grupodecontrole/Suspended-Pendulum-Plant/(list of files, cad)

Other CAD files:
GUI/Based Works/Initial Work at PIC - RealTimeMeasure/invertedPendulum.X/dist/default/production/invertedPendulum.X.production.obj
GUI/invertedPendulum.X/dist/default/production/invertedPendulum.X.production.obj
