grupodecontrole/Suspended-Pendulum-Plant/Draw.io/Modelagem - Pendulo Invertido.pdf

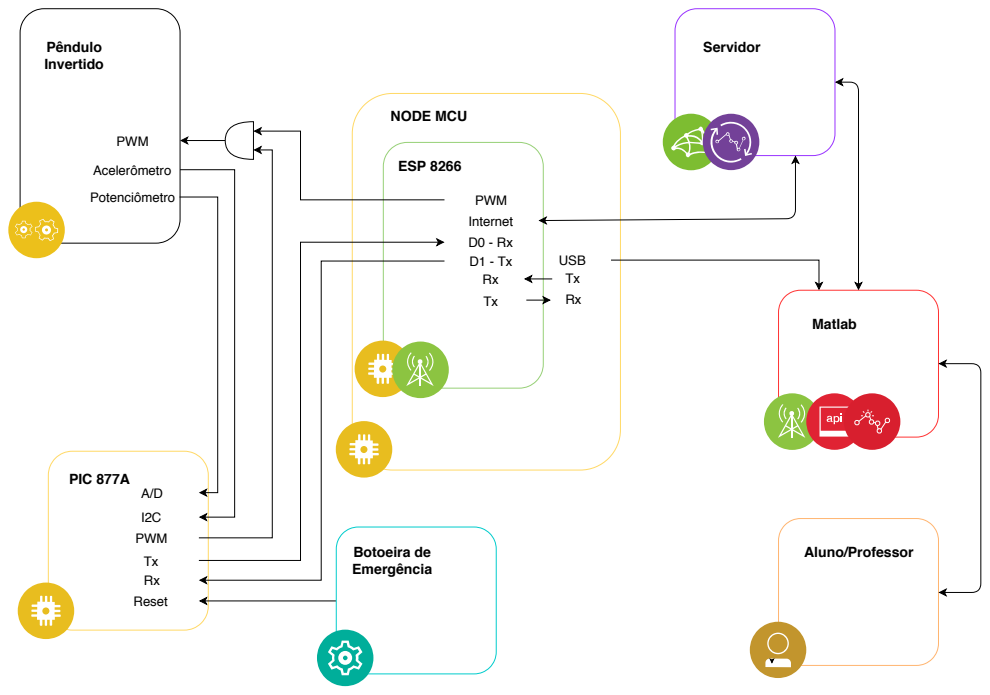
[picture p19: page 1]
PIC 877A; ESP 8266; Matlab; Botoeira de Emergência; PWM; Reset; Pêndulo; Servidor; Invertido; Acelerômetro; Potenciômetro; Internet; Aluno/Professor; NODE MCU; USB Tx
