grupodecontrole/Suspended-Pendulum-Plant/Kicad/board.pdf

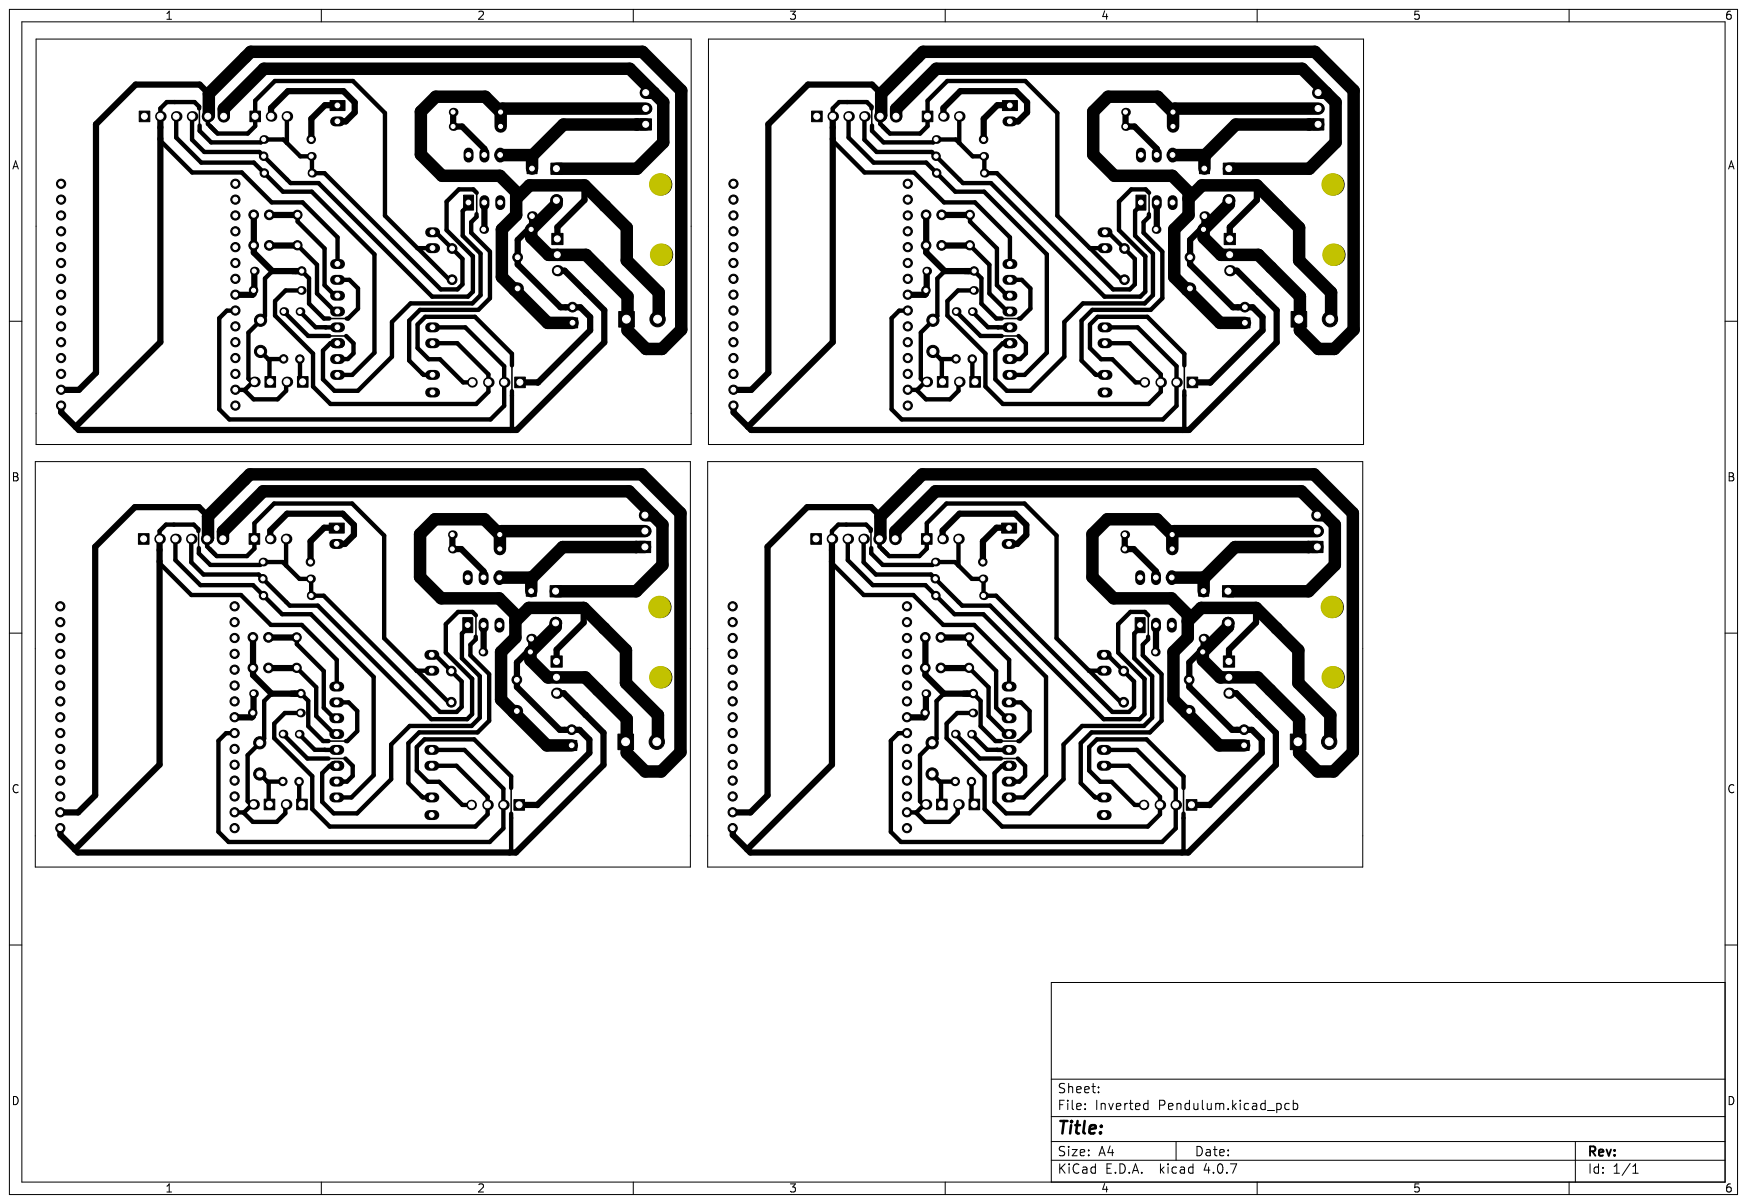
[picture p20: page 1]
