grupodecontrole/Suspended-Pendulum-Plant/(list of files, drawings)

Other design files:
Proteus/Simulation.pdsprj
