grupodecontrole/Suspended-Pendulum-Plant/Kicad/Inverted Pendulum.sch

## KiCad design Kicad/Inverted Pendulum.sch (2018-11-11)

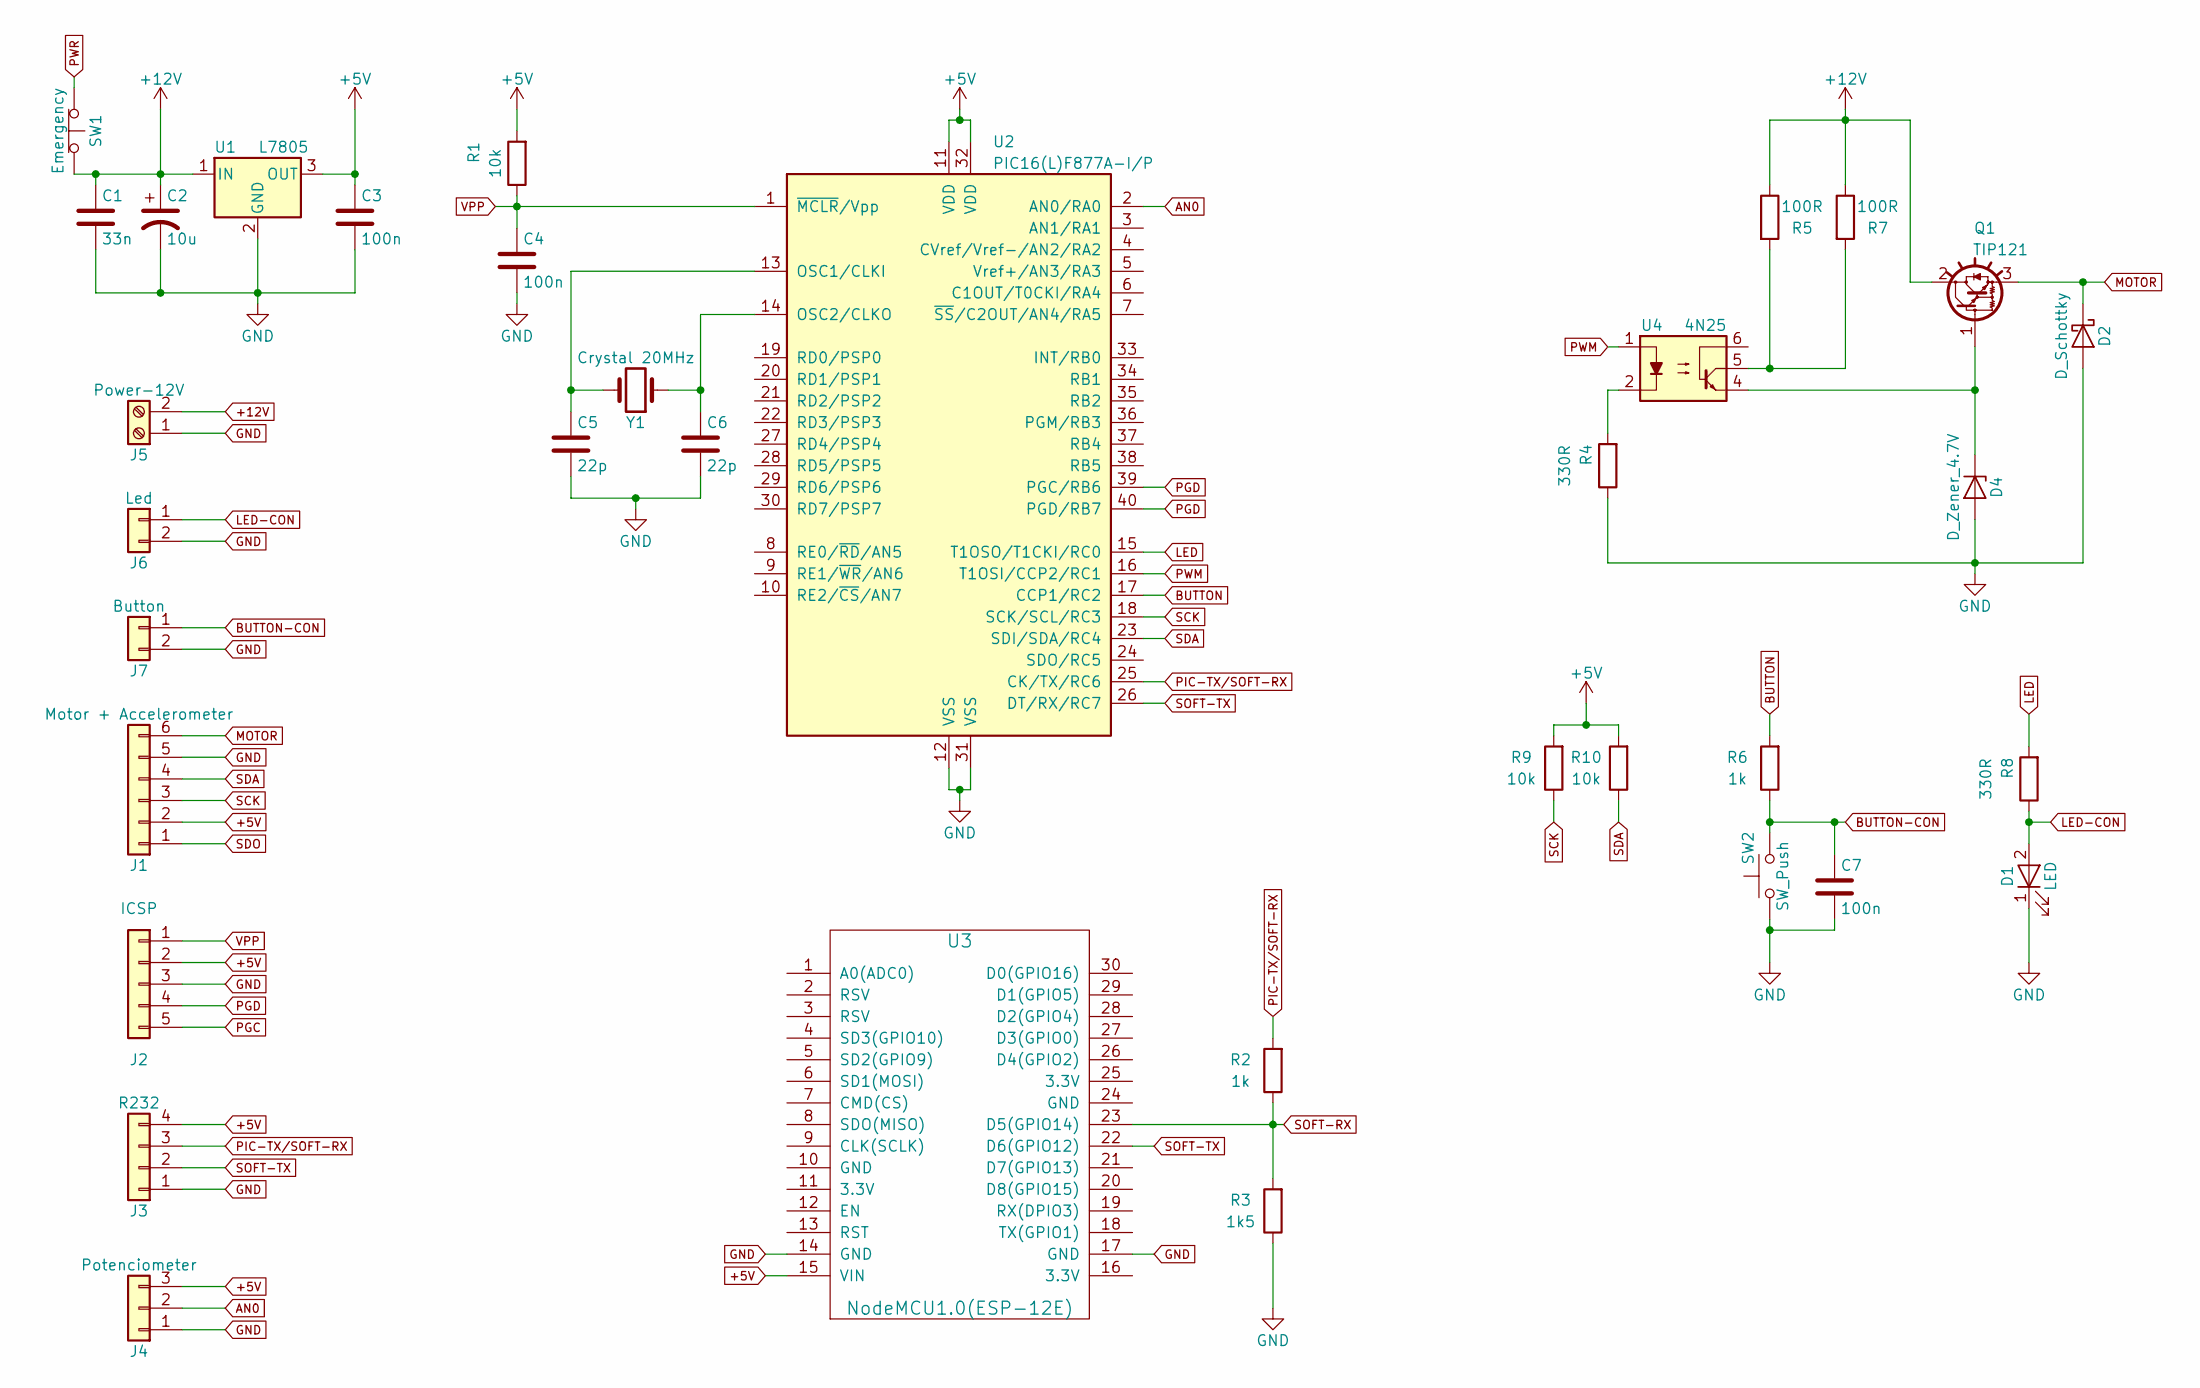
[picture p21: schematic Inverted Pendulum.sch]

Parts:
C1: 33n; C_Disc_D7.5mm_W4.4mm_P5.00mm
C2: 10u; CP_Radial_D7.5mm_P2.50mm
C3, C4, C7: 100n; C_Disc_D7.5mm_W5.0mm_P5.00mm
C5, C6: 22p; C_Disc_D3.8mm_W2.6mm_P2.50mm
D1: LED
D2: D_Schottky; TO-220-2_Horizontal
D4: D_Zener_4.7V; D_DO-35_SOD27_P7.62mm_Horizontal
J1: Motor + Accelerometer; Pin_Header_Angled_1x06_Pitch2.54mm
J2: ICSP
J3: R232; Pin_Header_Angled_1x04_Pitch2.54mm
J4: Potenciometer; Pin_Header_Angled_1x03_Pitch2.54mm
J5: Power-12V; TerminalBlock_Phoenix_MKDS1.5-2pol
J6: Led; Pin_Header_Angled_1x02_Pitch2.54mm
J7: Button; Pin_Header_Angled_1x02_Pitch2.54mm
Q1: TIP121; TO-220-3_Vertical
R1, R9, R10: 10k; R_Axial_DIN0204_L3.6mm_D1.6mm_P7.62mm_Horizontal
R2, R6: 1k; R_Axial_DIN0204_L3.6mm_D1.6mm_P7.62mm_Horizontal
R3: 1k5; R_Axial_DIN0204_L3.6mm_D1.6mm_P7.62mm_Horizontal
R4, R8: 330R; R_Axial_DIN0204_L3.6mm_D1.6mm_P7.62mm_Horizontal
R5, R7: 100R; R_Axial_DIN0204_L3.6mm_D1.6mm_P7.62mm_Horizontal
SW1: Emergency
SW2: SW_Push
U1: L7805; TO-220-3_Horizontal
U2: PIC16(L)F877A-I/P; DIP-40_W15.24mm_LongPads
U3: NodeMCU1.0(ESP-12E); NodeMCU1.0(12-E)
U4: 4N25; DIP-6_W7.62mm_LongPads
Y1: Crystal 20MHz; Crystal_HC49-4H_Vertical

Connections:
+5V: C3.1, J1.2, J2.2, J3.4, J4.3, R1.2, R9.2, R10.2, U1.3 (OUT), U2.11 (VDD), U2.32 (VDD), U3.15 (VIN)
+12V: C1.1, C2.1, J5.2, Q1.2 (C), R5.1, R7.1, SW1.2 (B), U1.1 (IN)
AN0: J4.2, U2.2 (AN0/RA0)
BUTTON: R6.2, U2.17 (CCP1/RC2)
BUTTON-CON: C7.1, J7.1, R6.1, SW2.2
GND: C1.2, C2.2, C3.2, C4.2, C5.2, C6.2, C7.2, D1.1 (K), D2.2 (A), D4.2 (A), J1.5, J2.3, J3.1, J4.1, J5.1, J6.2, J7.2, R3.1, R4.1, SW2.1, U1.2 (GND), U2.12 (VSS), U2.31 (VSS), U3.14 (GND), U3.17 (GND)
LED: R8.2, U2.15 (T1OSO/T1CKI/RC0)
LED-CON: D1.2 (A), J6.1, R8.1
MOTOR: D2.1 (K), J1.6, Q1.3 (E)
unnamed: C5.1, U2.13 (OSC1/CLKI), Y1.2
unnamed: C6.1, U2.14 (OSC2/CLKO), Y1.1
unnamed: D4.1 (K), Q1.1 (B), U4.4
unnamed: R4.2, U4.2
unnamed: R5.2, R7.2, U4.5
PGC: J2.5
PGD: J2.4, U2.39 (PGC/RB6), U2.40 (PGD/RB7)
PIC-TX/SOFT-RX: J3.3, R2.2, U2.25 (CK/TX/RC6)
PWM: U2.16 (T1OSI/CCP2/RC1), U4.1
PWR: SW1.1 (A)
SCK: J1.3, R9.1, U2.18 (SCK/SCL/RC3)
SDA: J1.4, R10.1, U2.23 (SDI/SDA/RC4)
SDO: J1.1
SOFT-RX: R2.1, R3.2, U3.23 (D5(GPIO14))
SOFT-TX: J3.2, U2.26 (DT/RX/RC7), U3.22 (D6(GPIO12))
VPP: C4.1, J2.1, R1.1, U2.1 (~MCLR~/Vpp)
