grupodecontrole/Suspended-Pendulum-Plant/GUI/Based Works/accelerometer_arduino/accelerometer_arduino.ino

#include <Wire.h>
#define accel_module (0x53) //Ground the SD0
byte values[6] ;
char output[512];

void setup(){
  Wire.begin();
  Serial.begin(9600);
  
  Wire.beginTransmission(accel_module);
  Wire.write(0x2D);
  Wire.write(0);
  Wire.endTransmission();
  Wire.beginTransmission(accel_module);
  Wire.write(0x2D);
  Wire.write(16);
  Wire.endTransmission();
  Wire.beginTransmission(accel_module);
  Wire.write(0x2D);
  Wire.write(8);
  Wire.endTransmission();
}

void loop(){
    Serial.print("Loop"); 

  int xyzregister = 0x32;
  int x, y, z;
  
  Wire.beginTransmission(accel_module);
  Wire.write(xyzregister);
  Wire.endTransmission();
  
  Wire.beginTransmission(accel_module);
  Wire.requestFrom(accel_module, 6);
  
  int i = 0;
  while(Wire.available()){
    values[i] = Wire.read();
    i++;
  }
  Wire.endTransmission();
  int pos = analogRead(A0);
  
  x = (((int)values[1]) << 8) | values[0]; 
  y = (((int)values[3])<< 8) | values[2]; 
  z = (((int)values[5]) << 8) | values[4]; 
  sprintf(output, "%d %d %d %d",pos, x, y, z); 
  Serial.print(output); 
  Serial.write(10); 
  delay(1000); 
}
