grupodecontrole/Suspended-Pendulum-Plant/(commit log)

2018-11-11 a lot of modifications
    [Inverted Pendulum.kicad_pcb, Inverted Pendulum.sch, Simulation.pdsprj, invertedPendulum.X.production.obj]
2018-11-12 add ledRed
    [invertedPendulum.X.production.obj]
2018-12-10 add matlab yago
    [invertedPendulum.X.production.obj]
